shaneleonard/bioshield/README.md

# bioshield
Arduino shield for biomedical instrumentation. Includes an ECG, ICG, and PPG. For educational purposes.
