shaneleonard/bioshield/bioshield.brd

## EAGLE design bioshield.brd (2016-05-28)

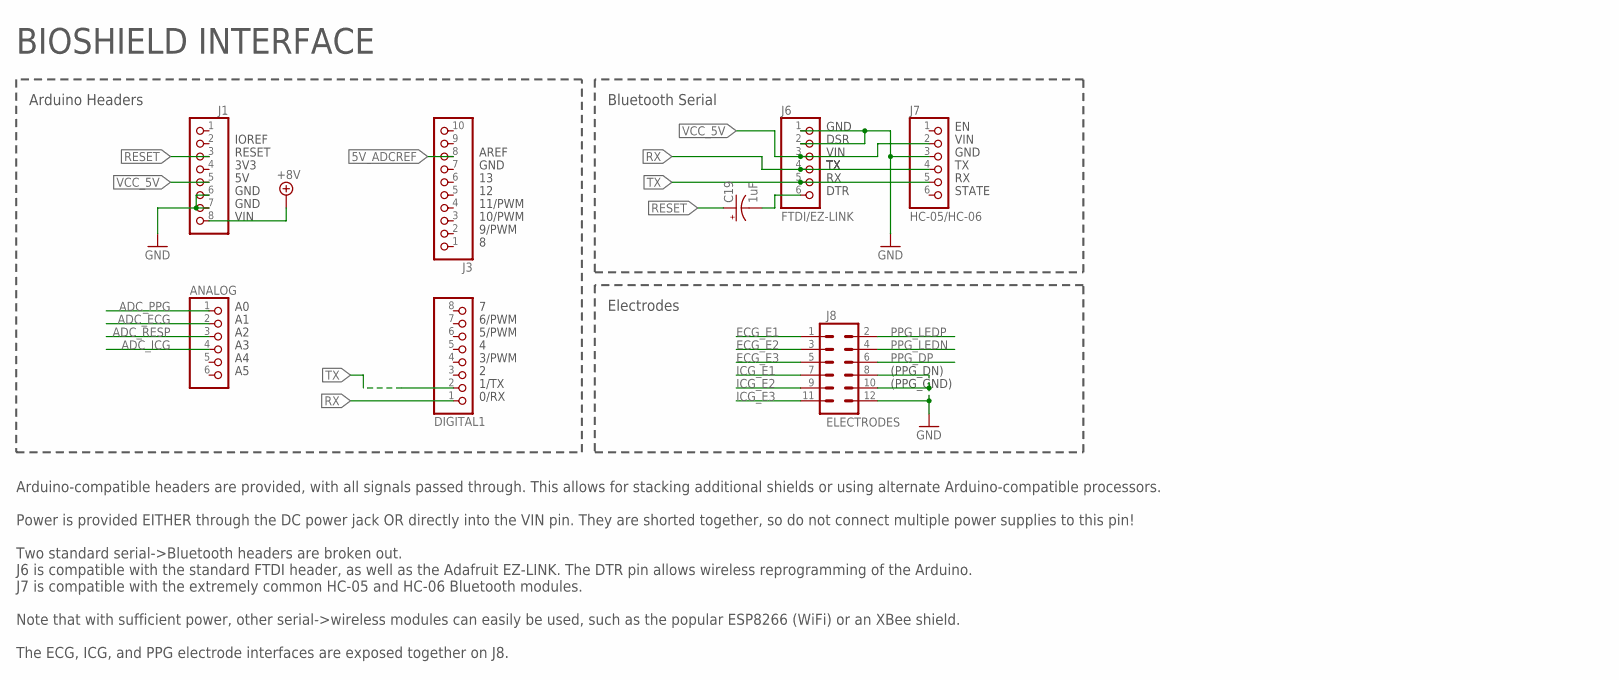
[picture p8: schematic bioshield.sch, sheet 1, INTERFACE]

Parts:
ANALOG: PINHD-1X6; 1X06
C19: 1uF; E2-5
DIGITAL1: PINHD-1X8TH; 1X08-TH
J1: PINHD-1X8TH; 1X08-TH
J3: PINHD-1X10TH; 1X10-TH
J6: FTDI/EZ-LINK; 1X06
J7: HC-05/HC-06; 1X06
J8: ELECTRODES; 2X6

Connections:
5V_ADCREF: J3.8; also elsewhere on the board
+8V: J1.8; also elsewhere on the board
ADC_ECG: ANALOG.2; also elsewhere on the board
ADC_ICG: ANALOG.4; also elsewhere on the board
ADC_PPG: ANALOG.1; also elsewhere on the board
ADC_RESP: ANALOG.3; also elsewhere on the board
ECG_E1: J8.1; also elsewhere on the board
ECG_E2: J8.3; also elsewhere on the board
ECG_E3: J8.5; also elsewhere on the board
GND: J1.6, J1.7, J6.1, J6.2, J7.3, J8.8, J8.10, J8.12; also elsewhere on the board
ICG_E1: J8.7; also elsewhere on the board
ICG_E2: J8.9; also elsewhere on the board
ICG_E3: J8.11; also elsewhere on the board
unnamed: C19.-, J6.6
PPG_DP: J8.6; also elsewhere on the board
PPG_LEDN: J8.4; also elsewhere on the board
PPG_LEDP: J8.2; also elsewhere on the board
RESET: C19.+, J1.3
RX: DIGITAL1.1, J6.4, J7.4
TX: DIGITAL1.2, J6.5, J7.5
VCC_5V: J1.5, J6.3, J7.2; also elsewhere on the board

Notes on the sheet:
BIOSHIELD INTERFACE
IOREF
RESET
3V3
GND
VIN
AREF
11/PWM
10/PWM
9/PWM
6/PWM
5/PWM
3/PWM
1/TX
0/RX
DSR
DTR
STATE
Arduino Headers
Bluetooth Serial
Electrodes
Arduino-compatible headers are provided, with all signals passed through. This allows for stacking additional shields or using alternate Arduino-compatible processors. Power is provided EITHER through the DC power jack OR directly into the VIN pin. They are shorted together, so do not connect multi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
(PPG_DN)
(PPG_GND)

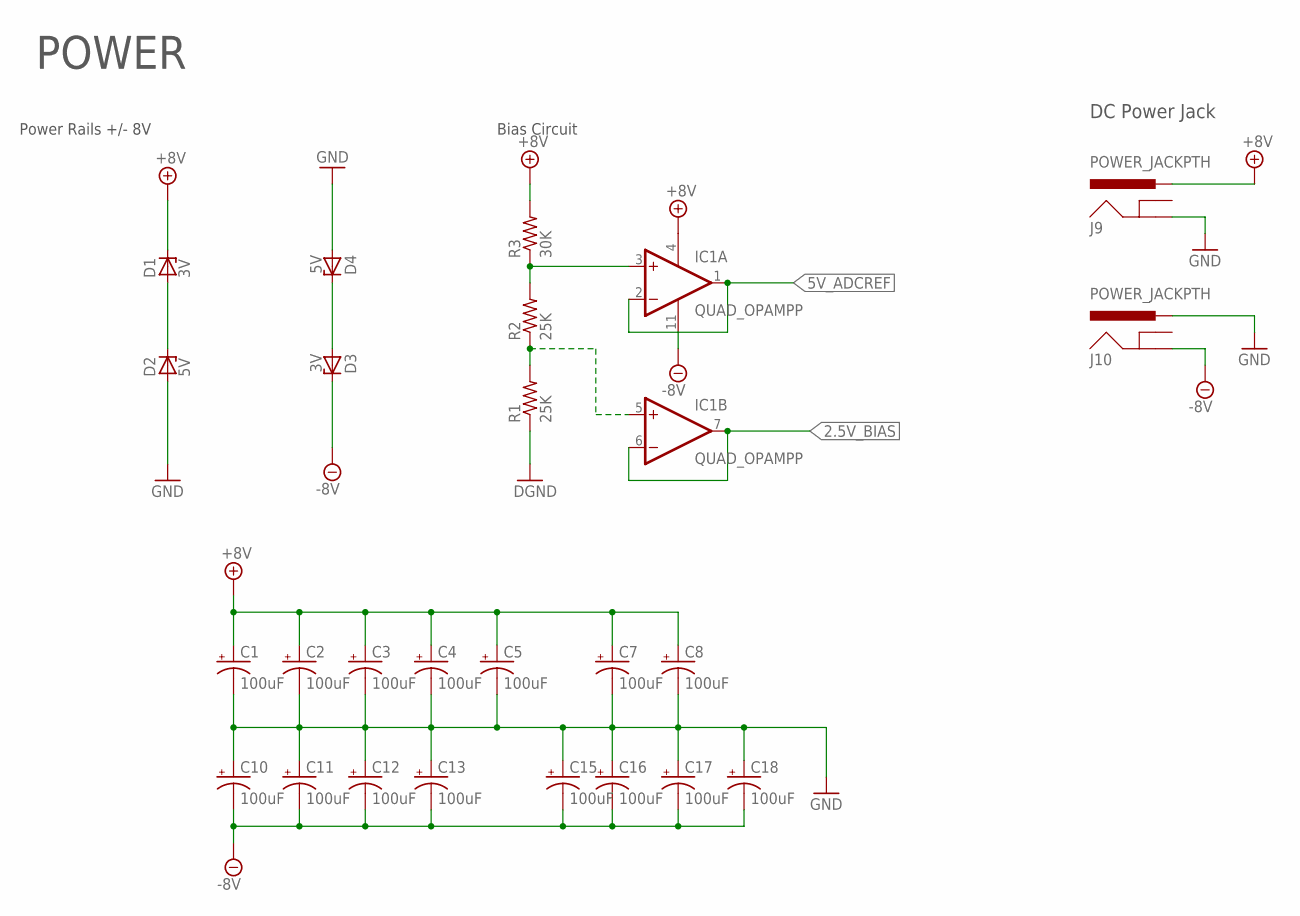
[picture p9: schematic bioshield.sch, sheet 2, POWER]

Parts:
C1, C2, C3, C4, C5, C7, C8, C10, C11, C12, C13, C15, C16, C17, C18: 100uF; CPOL-RADIAL-100UF-25V
D1, D3: 3V; ZDIO-10
D2, D4: 5V; ZDIO-10
IC1: QUAD_OPAMPP; DIL14
J9, J10: POWER_JACKPTH; POWER_JACK_PTH
R1, R2: 25K; 0207/10
R3: 30K; 0207/10

Connections:
2.5V_BIAS: IC1.6 (-IN), IC1.7 (OUT); also elsewhere on the board
5V_ADCREF: IC1.1 (OUT), IC1.2 (-IN); also elsewhere on the board
+8V: C1.1 (+), C2.1 (+), C3.1 (+), C4.1 (+), C5.1 (+), C7.1 (+), C8.1 (+), D1.C, IC1.4 (V+), J9.PWR, R3.2; also elsewhere on the board
-8V: C10.2 (-), C11.2 (-), C12.2 (-), C13.2 (-), C15.2 (-), C16.2 (-), C17.2 (-), C18.2 (-), D3.C, IC1.11 (V-), J10.GND; also elsewhere on the board
GND: C1.2 (-), C2.2 (-), C3.2 (-), C4.2 (-), C5.2 (-), C7.2 (-), C8.2 (-), C10.1 (+), C11.1 (+), C12.1 (+), C13.1 (+), C15.1 (+), C16.1 (+), C17.1 (+), C18.1 (+), D2.A, D4.A, J9.GND, J10.PWR, R1.1; also elsewhere on the board
unnamed: IC1.5 (+IN), R1.2, R2.1
unnamed: D1.A, D2.C
unnamed: IC1.3 (+IN), R2.2, R3.1
unnamed: D3.A, D4.C

Notes on the sheet:
POWER
Power Rails +/- 8V
Bias Circuit
DC Power Jack

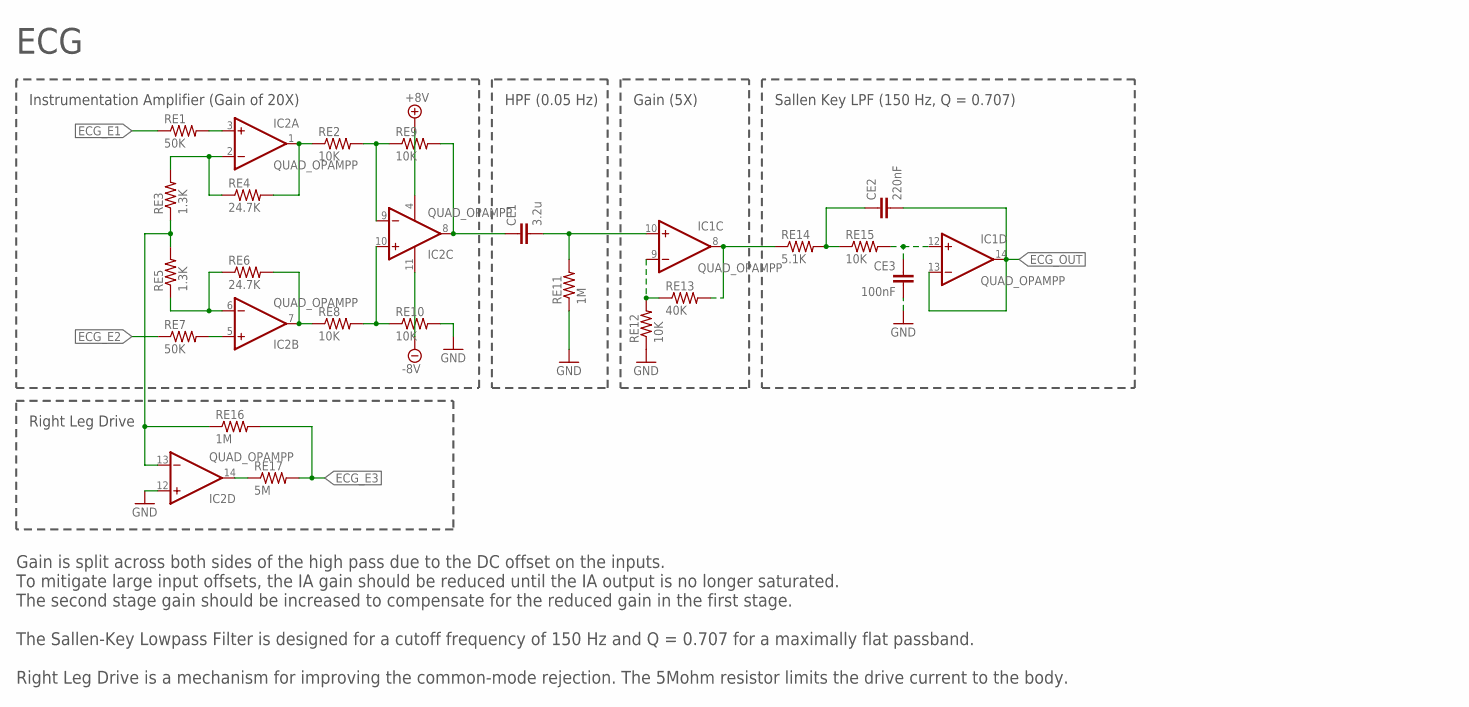
[picture p10: schematic bioshield.sch, sheet 3, ECG]

Parts:
CE1: 3.2u; CAP-PTH-5MM
CE2: 220nF; CAP-PTH-5MM
CE3: 100nF; CAP-PTH-5MM
IC1, IC2: QUAD_OPAMPP; DIL14
RE1, RE7: 50K; 0207/10
RE2, RE8, RE9, RE10, RE12, RE15: 10K; 0207/10
RE3, RE5: 1.3K; 0207/10
RE4, RE6: 24.7K; 0207/10
RE11, RE16: 1M; 0207/10
RE13: 40K; 0207/10
RE14: 5.1K; 0207/10
RE17: 5M; 0207/10

Connections:
+8V: IC2.4 (V+); also elsewhere on the board
-8V: IC2.11 (V-); also elsewhere on the board
ECG_E1: RE1.1; also elsewhere on the board
ECG_E2: RE7.1; also elsewhere on the board
ECG_E3: RE16.2, RE17.2; also elsewhere on the board
ECG_OUT: CE2.2, IC1.13 (-IN), IC1.14 (OUT); also elsewhere on the board
GND: CE3.2, IC2.12 (+IN), RE10.2, RE11.1, RE12.1; also elsewhere on the board
unnamed: IC1.9 (-IN), RE12.2, RE13.1
unnamed: CE1.2, IC1.10 (+IN), RE11.2
unnamed: CE3.1, IC1.12 (+IN), RE15.2
unnamed: IC1.8 (OUT), RE13.2, RE14.1
unnamed: CE2.1, RE14.2, RE15.1
unnamed: IC2.14 (OUT), RE17.1
unnamed: IC2.5 (+IN), RE7.2
unnamed: IC2.13 (-IN), RE3.1, RE5.2, RE16.1
unnamed: IC2.6 (-IN), RE5.1, RE6.1
unnamed: IC2.7 (OUT), RE6.2, RE8.1
unnamed: IC2.10 (+IN), RE8.2, RE10.1
unnamed: IC2.2 (-IN), RE3.2, RE4.1
unnamed: IC2.1 (OUT), RE2.1, RE4.2
unnamed: IC2.3 (+IN), RE1.2
unnamed: IC2.9 (-IN), RE2.2, RE9.1
unnamed: CE1.1, IC2.8 (OUT), RE9.2

Notes on the sheet:
Instrumentation Amplifier (Gain of 20X)
HPF (0.05 Hz)
Gain (5X)
Sallen Key LPF (150 Hz, Q = 0.707)
Right Leg Drive
ECG
Gain is split across both sides of the high pass due to the DC offset on the inputs. To mitigate large input offsets, the IA gain should be reduced until the IA output is no longer saturated. The second stage gain should be increased to compensate for the reduced gain in the first stage. The Sallen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

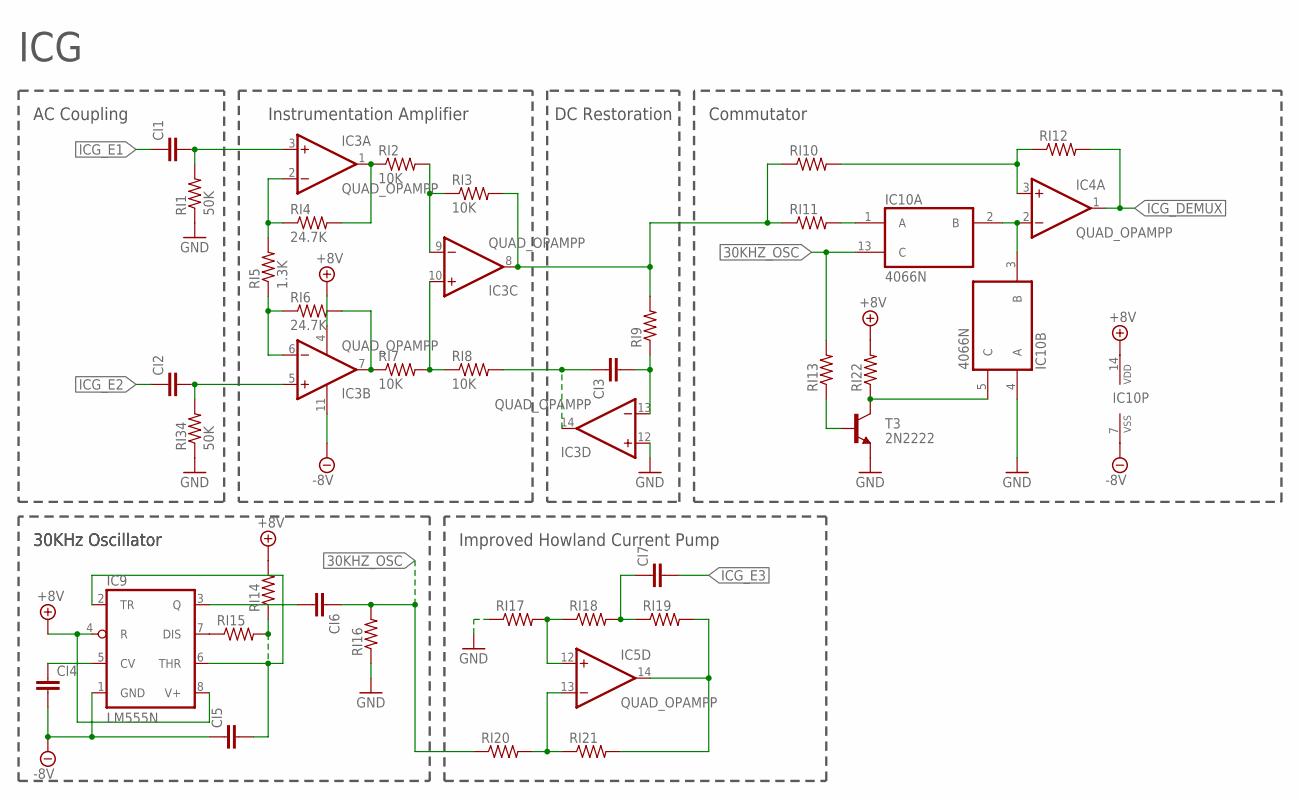
[picture p11: schematic bioshield.sch, sheet 4, ICG]

Parts:
CI1, CI2, CI3, CI4, CI5, CI6, CI7: CAPPTH1; CAP-PTH-5MM
IC3, IC4, IC5: QUAD_OPAMPP; DIL14
IC9: LM555N; DIL08
IC10: 4066N; DIL14
RI1, RI34: 50K; 0207/10
RI2, RI3, RI7, RI8: 10K; 0207/10
RI4, RI6: 24.7K; 0207/10
RI5: 1.3K; 0207/10
RI9, RI10, RI11, RI12, RI13, RI14, RI15, RI16, RI17, RI18, RI19, RI20, RI21, RI22: R-US_0207/10; 0207/10
T3: 2N2222; TO92-EBC-OVAL

Connections:
30KHZ_OSC: CI6.1, IC10.13 (C), RI13.2, RI16.2, RI20.1
+8V: IC3.4 (V+), IC9.4 (R), IC9.8 (V+), IC10.14 (VDD), RI14.2, RI22.2; also elsewhere on the board
-8V: CI4.2, CI5.1, IC3.11 (V-), IC9.1 (GND), IC10.7 (VSS); also elsewhere on the board
ELECTRODE3: CI7.1, RI18.2, RI19.1
GND: IC3.12 (+IN), IC10.4 (A), RI1.1, RI16.1, RI17.1, RI34.1, T3.E; also elsewhere on the board
ICG_DEMUX: IC4.1 (OUT), RI12.2; also elsewhere on the board
ICG_E1: CI1.1; also elsewhere on the board
ICG_E2: CI2.1; also elsewhere on the board
ICG_E3: CI7.2; also elsewhere on the board
unnamed: CI2.2, IC3.5 (+IN), RI34.2
unnamed: CI3.1, IC3.14 (OUT), RI8.2
unnamed: IC3.6 (-IN), RI5.1, RI6.1
unnamed: IC3.7 (OUT), RI6.2, RI7.1
unnamed: CI5.2, IC9.2 (TR), IC9.6 (THR), RI14.1, RI15.2
unnamed: IC10.1 (A), RI11.2
unnamed: IC9.7 (DIS), RI15.1
unnamed: IC4.2 (-IN), IC10.2 (B), IC10.3 (B)
unnamed: RI13.1, T3.B
unnamed: CI4.1, IC9.5 (CV)
unnamed: CI6.2, IC9.3 (Q)
unnamed: IC3.10 (+IN), RI7.2, RI8.1
unnamed: IC3.2 (-IN), RI4.1, RI5.2
unnamed: IC3.1 (OUT), RI2.1, RI4.2
unnamed: CI1.2, IC3.3 (+IN), RI1.2
unnamed: IC3.9 (-IN), RI2.2, RI3.1
unnamed: IC3.8 (OUT), RI3.2, RI9.2, RI10.1, RI11.1
unnamed: IC5.13 (-IN), RI20.2, RI21.1
unnamed: IC5.12 (+IN), RI17.2, RI18.1
unnamed: CI3.2, IC3.13 (-IN), RI9.1
unnamed: IC4.3 (+IN), RI10.2, RI12.1
RI13: IC10.5 (C), RI22.1, T3.C
V+: IC5.14 (OUT), RI19.2, RI21.2

Notes on the sheet:
ICG
AC Coupling
Instrumentation Amplifier
Commutator
30KHz Oscillator
Improved Howland Current Pump
DC Restoration

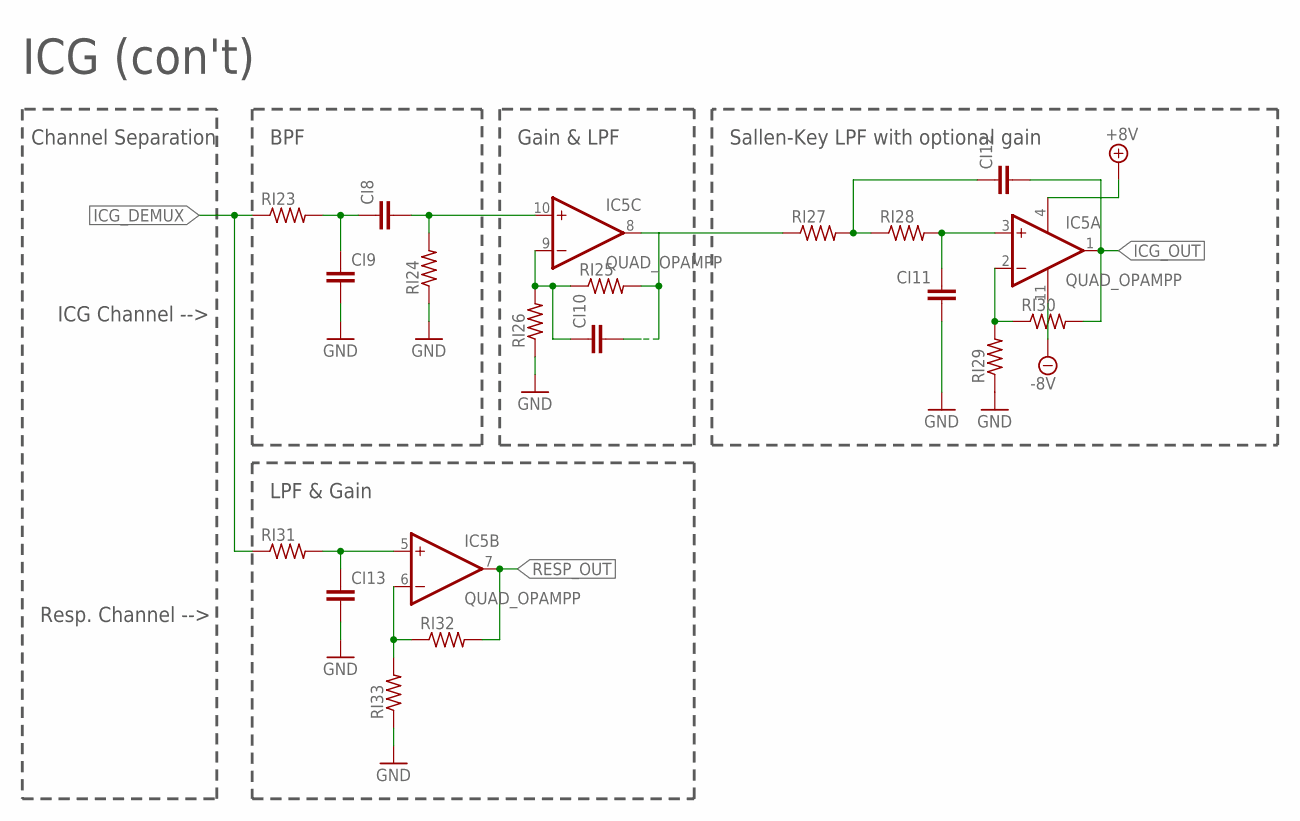
[picture p12: schematic bioshield.sch, sheet 5, ICG con't]

Parts:
CI8, CI9, CI10, CI11, CI12, CI13: CAPPTH1; CAP-PTH-5MM
IC5: QUAD_OPAMPP; DIL14
RI23, RI24, RI25, RI26, RI27, RI28, RI29, RI30, RI31, RI32, RI33: R-US_0207/10; 0207/10

Connections:
+8V: IC5.4 (V+); also elsewhere on the board
-8V: IC5.11 (V-); also elsewhere on the board
GND: CI9.2, CI11.2, CI13.2, RI24.1, RI26.1, RI29.1, RI33.1; also elsewhere on the board
ICG_DEMUX: RI23.1, RI31.1; also elsewhere on the board
ICG_OUT: CI12.2, IC5.1 (OUT), RI30.2; also elsewhere on the board
unnamed: CI13.1, IC5.5 (+IN), RI31.2
unnamed: CI8.2, IC5.10 (+IN), RI24.2
unnamed: CI10.1, IC5.9 (-IN), RI25.1, RI26.2
unnamed: IC5.6 (-IN), RI32.1, RI33.2
unnamed: CI12.1, RI27.2, RI28.1
unnamed: CI10.2, IC5.8 (OUT), RI25.2, RI27.1
unnamed: CI11.1, IC5.3 (+IN), RI28.2
unnamed: IC5.2 (-IN), RI29.2, RI30.1
unnamed: CI8.1, CI9.1, RI23.2
RESP_OUT: IC5.7 (OUT), RI32.2; also elsewhere on the board

Notes on the sheet:
ICG (con't)
BPF
Gain & LPF
Sallen-Key LPF with optional gain
LPF & Gain
Channel Separation
ICG Channel -->
Resp. Channel -->

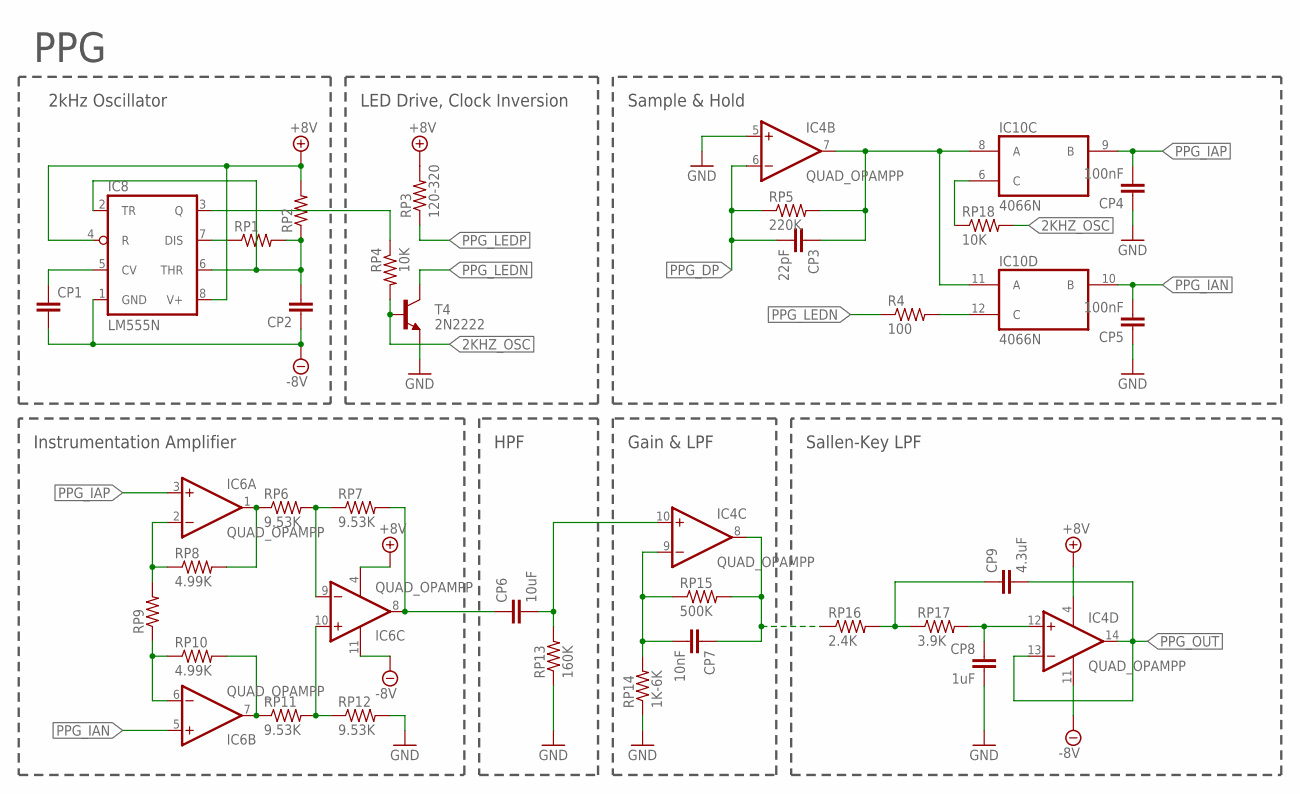
[picture p13: schematic bioshield.sch, sheet 6, PPG]

Parts:
CP1, CP2: CAPPTH1; CAP-PTH-5MM
CP3: 22pF; CAP-PTH-5MM
CP4, CP5: 100nF; CAP-PTH-5MM
CP6: 10uF; CAP-PTH-5MM
CP7: 10nF; CAP-PTH-5MM
CP8: 1uF; CAP-PTH-5MM
CP9: 4.3uF; CAP-PTH-5MM
IC4, IC6: QUAD_OPAMPP; DIL14
IC8: LM555N; DIL08
IC10: 4066N; DIL14
R4: 100; 0207/10
RP1, RP2, RP9: R-US_0207/10; 0207/10
RP3: 120-320; 0207/10
RP4, RP18: 10K; 0207/10
RP5: 220K; 0207/10
RP6, RP7, RP11, RP12: 9.53K; 0207/10
RP8, RP10: 4.99K; 0207/10
RP13: 160K; 0207/10
RP14: 1K-6K; 0207/10
RP15: 500K; 0207/10
RP16: 2.4K; 0207/10
RP17: 3.9K; 0207/10
T4: 2N2222; TO92-EBC-OVAL

Connections:
2KHZ_OSC: RP4.2, RP18.2, T4.B
+8V: IC4.4 (V+), IC6.4 (V+), IC8.4 (R), IC8.8 (V+), RP2.2, RP3.2; also elsewhere on the board
-8V: CP1.2, CP2.1, IC4.11 (V-), IC6.11 (V-), IC8.1 (GND); also elsewhere on the board
GND: CP4.1, CP5.1, CP8.2, IC4.5 (+IN), RP12.2, RP13.1, RP14.1, T4.E; also elsewhere on the board
unnamed: IC6.6 (-IN), RP9.1, RP10.1
unnamed: IC6.7 (OUT), RP10.2, RP11.1
unnamed: IC6.10 (+IN), RP11.2, RP12.1
unnamed: IC8.7 (DIS), RP1.1
unnamed: CP1.1, IC8.5 (CV)
unnamed: IC6.2 (-IN), RP8.1, RP9.2
unnamed: IC10.6 (C), RP18.1
unnamed: IC6.1 (OUT), RP6.1, RP8.2
unnamed: CP2.2, IC8.2 (TR), IC8.6 (THR), RP1.2, RP2.1
unnamed: IC6.9 (-IN), RP6.2, RP7.1
unnamed: CP6.1, IC6.8 (OUT), RP7.2
unnamed: CP3.1, IC4.7 (OUT), IC10.8 (A), IC10.11 (A), RP5.2
unnamed: CP6.2, IC4.10 (+IN), RP13.2
unnamed: IC10.12 (C), R4.2
unnamed: CP7.2, IC4.9 (-IN), RP14.2, RP15.1
unnamed: CP7.1, IC4.8 (OUT), RP15.2, RP16.1
unnamed: CP9.1, RP16.2, RP17.1
unnamed: CP8.1, IC4.12 (+IN), RP17.2
unnamed: IC8.3 (Q), RP4.1
PPG_DP: CP3.2, IC4.6 (-IN), RP5.1; also elsewhere on the board
PPG_IAN: CP5.2, IC6.5 (+IN), IC10.10 (B)
PPG_IAP: CP4.2, IC6.3 (+IN), IC10.9 (B)
PPG_LEDN: R4.1, T4.C; also elsewhere on the board
PPG_LEDP: RP3.1; also elsewhere on the board
PPG_OUT: CP9.2, IC4.13 (-IN), IC4.14 (OUT); also elsewhere on the board

Notes on the sheet:
PPG
2kHz Oscillator
LED Drive, Clock Inversion
Sample & Hold
Instrumentation Amplifier
HPF
Gain & LPF
Sallen-Key LPF

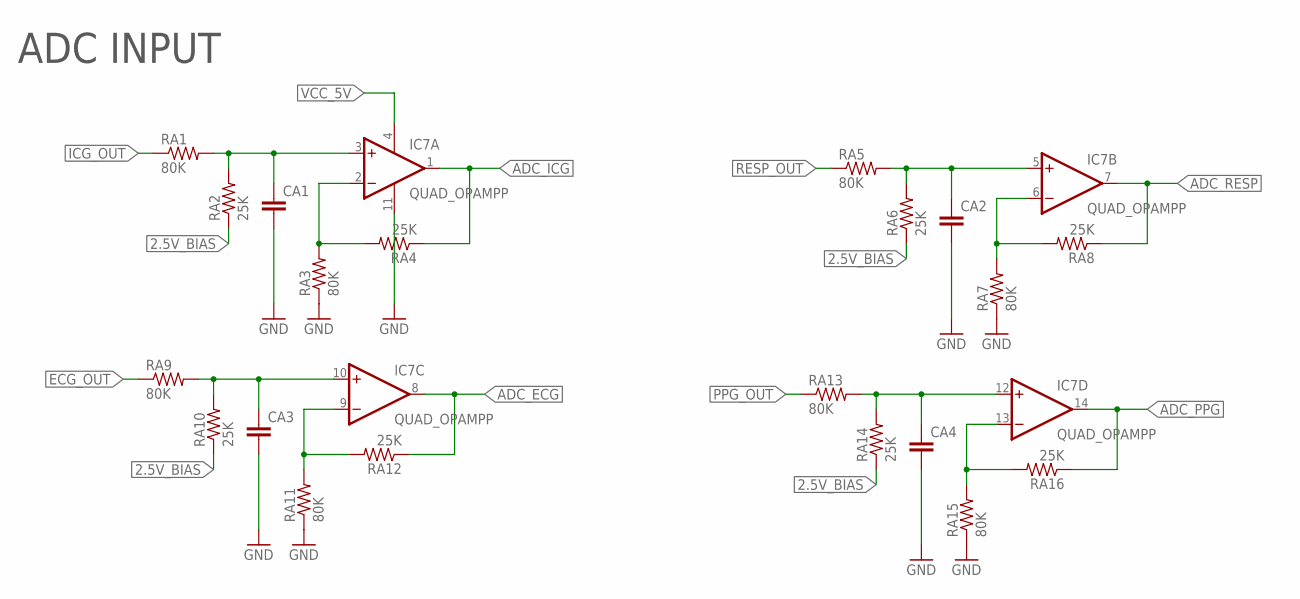
[picture p14: schematic bioshield.sch, sheet 7, ADC INPUT]

Parts:
CA1, CA2, CA3, CA4: CAPPTH1; CAP-PTH-5MM
IC7: QUAD_OPAMPP; DIL14
RA1, RA3, RA5, RA7, RA9, RA11, RA13, RA15: 80K; 0207/10
RA2, RA4, RA6, RA8, RA10, RA12, RA14, RA16: 25K; 0207/10

Connections:
2.5V_BIAS: RA2.1, RA6.1, RA10.1, RA14.1; also elsewhere on the board
ADC_ECG: IC7.8 (OUT), RA12.1; also elsewhere on the board
ADC_ICG: IC7.1 (OUT), RA4.1; also elsewhere on the board
ADC_PPG: IC7.14 (OUT), RA16.1; also elsewhere on the board
ADC_RESP: IC7.7 (OUT), RA8.1; also elsewhere on the board
ECG_OUT: RA9.1; also elsewhere on the board
GND: CA1.2, CA2.2, CA3.2, CA4.2, IC7.11 (V-), RA3.1, RA7.1, RA11.1, RA15.1; also elsewhere on the board
ICG_OUT: RA1.1; also elsewhere on the board
unnamed: CA1.1, IC7.3 (+IN), RA1.2, RA2.2
unnamed: IC7.2 (-IN), RA3.2, RA4.2
unnamed: CA2.1, IC7.5 (+IN), RA5.2, RA6.2
unnamed: IC7.6 (-IN), RA7.2, RA8.2
unnamed: CA3.1, IC7.10 (+IN), RA9.2, RA10.2
unnamed: IC7.9 (-IN), RA11.2, RA12.2
unnamed: CA4.1, IC7.12 (+IN), RA13.2, RA14.2
unnamed: IC7.13 (-IN), RA15.2, RA16.2
PPG_OUT: RA13.1; also elsewhere on the board
RESP_OUT: RA5.1; also elsewhere on the board
VCC_5V: IC7.4 (V+); also elsewhere on the board

Notes on the sheet:
ADC INPUT

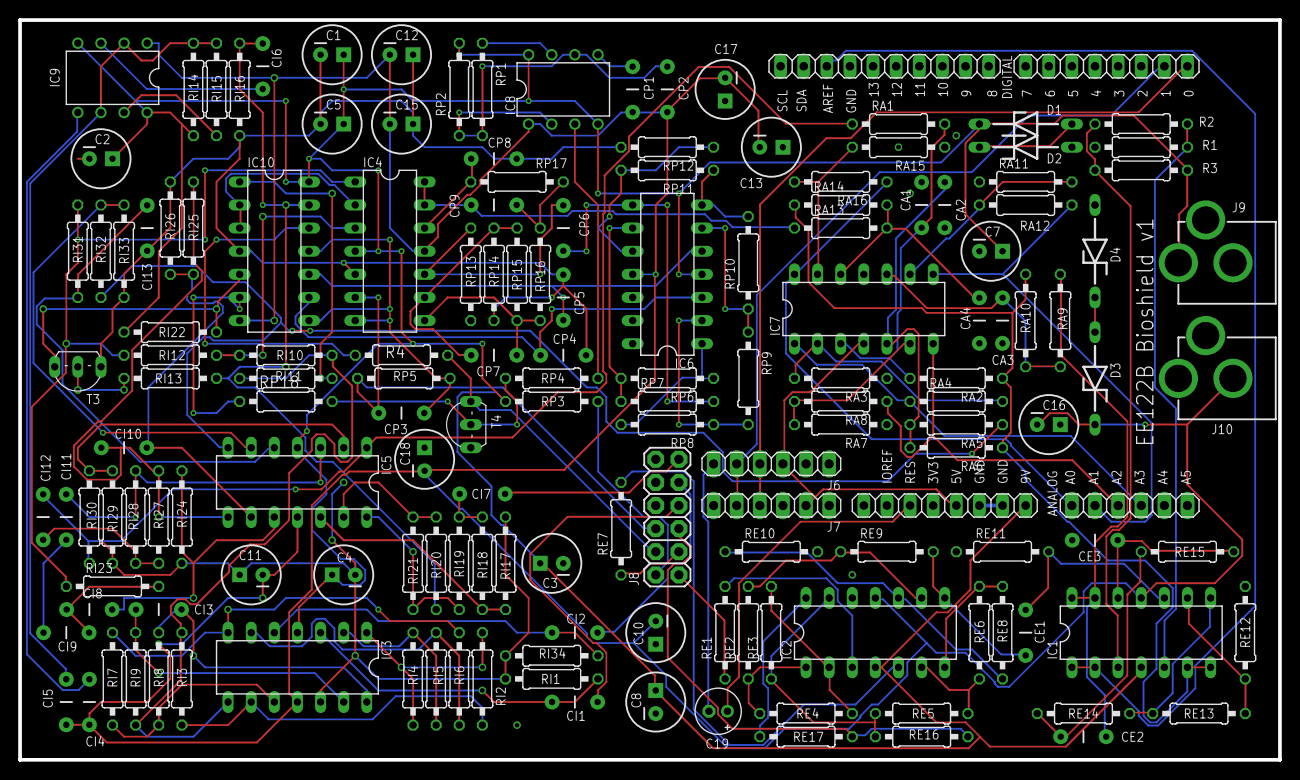
[picture p15: board bioshield.brd from above]

Board: 2 copper layers, 138.4 x 81.3 mm, 159 parts (1 on the bottom side), 112 nets.
