shaneleonard/bioshield/(commit log)

2016-05-22 All blocks are in progress
    [bioshield.brd, bioshield.sch, ecg.sch]
2016-05-23 Schematic nearly complete
    [bioshield.brd, bioshield.sch]
2016-05-25 Grouped items in layout
    [bioshield.brd, bioshield.sch]
2016-05-25 ICG somewhat good
    [bioshield.brd]
2016-05-26 Revision 1
    [bioshield.brd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]
2016-05-26 Schematic visually consistent
    [bioshield.brd, bioshield.sch]
